gringolito/nearfield-speakers-support/nearfield-wall-mount.scad

// nearfield-wall-mount.scad
// Top-level: parameters (Customizer-friendly) + render_piece dispatch.

include <modules/common.scad>;
include <modules/joinery.scad>;
include <modules/base.scad>;
include <modules/platform.scad>;
include <modules/arm.scad>;

/* [Render] */
// 0 = assembly preview
// 1 = base-right          2 = base-left
// 3 = arm-right           4 = arm-left
// 5 = platform-right      6 = platform-left
render_piece = 0; // [0:assembly, 1:base-right, 2:base-left, 3:arm-right, 4:arm-left, 5:platform-right, 6:platform-left]

/* [Acoustic angles] */
toe_in_deg = 26; // [20:1:30]
tilt_deg   = 12; // [10:1:15]

/* [Arm geometry] */
arm_length  = 45;  // [40:5:100]
arm_root_h  = 60;  // [50:5:70]
arm_tip_h   = 28;  // [25:1:40]
arm_w       = 40;  // [35:5:50]

/* [Base geometry] */
base_h = 140; // [140:10:220]
base_w = 90;  // [80:10:140]
base_t = 6;   // [6:2:28]

/* [Base boss] */
// Frontal boss at the arm joint. Sized to match the arm's root cross-section
// so the boss visually reads as a continuation of the arm into the base. Its
// depth (in +Z) carries the lateral clamping screws into heat-set inserts in
// the arm root tenon. The boss front face is intentionally clipped flat (no
// fillet bulge) so it mates flush against the arm root.
boss_w       = arm_w;      // [30:2:50]   match arm_w
boss_h       = arm_root_h; // [40:5:70]   match arm_root_h
boss_depth   = 15;         // [15:1:25]
// Explicit chamfered skirt blending the boss into the slab. Height of the
// chamfer along +Z; lateral expansion at the slab is equal to this. 0 =
// no skirt (rely only on the minkowski fillet at the boss/slab corner).
boss_blend_h = 4;  // [0:1:8]

/* [Platform geometry] */
plat_depth        = 200;   // [200:10:300]
plat_w            = 130;   // [130:2:140]
plat_t            = 8;     // [8:1:14]
plat_boss_w       = arm_w; // [30:2:50]   match arm_w
plat_boss_depth   = 28;    // [25:1:40]
// Total back-face height of the boss = plat_t + plat_boss_extra_t.
// Sized to match arm_tip_h so the boss covers the entire arm tip face,
// making the joint read as a single piece (mirrors how boss_h matches
// arm_root_h at the base end of the arm).
plat_boss_extra_t = arm_tip_h - plat_t;  // [10:1:32]   match arm_tip_h - plat_t
// The mortise is centered at (plat_t + plat_boss_extra_t)/2 below the
// slab top — i.e., at the geometric center of the back face — so the
// arm tip face (also centered on its tenon) lands centered on the back
// face. No standalone mortise-drop parameter is needed: the back-face
// center IS the mortise. Keep plat_t + plat_boss_extra_t ≈ arm_tip_h to
// make the boss/slab back face cover the arm tip face exactly.
lip_h             = 15;  // [12:1:18]
lip_t             = 5;   // [5:1:8]

/* [Joints] */
tenon_h_plat = 12;
tenon_w_plat = 25;
tenon_l_plat = 20;
tenon_h_base = 25;
tenon_w_base = 22;
// Root tenon is fully passthrough — spans the slab plus the frontal boss.
tenon_l_base = base_t + boss_depth;
tenon_clearance = 0.1;  // per-side
insert_spacing  = 10;

/* [Wall mounting] */
wall_screw_count   = 2;
wall_screw_spacing = 100;

/* [Fillets & Chamfers] */
edge_r   = 2.0; // [0:0.5:6]
fillet_r = 1.0; // [0:0.5:6]
chamfer  = 1.0; // [0:0.5:6]

/* [Quality] */
$fn = 64;

// Sanity asserts on parameters that interact:
assert(tenon_l_plat + 5 <= plat_boss_depth,
       "platform mortise depth + 5 mm back wall must fit within platform thickness at boss");
assert(arm_tip_h <= arm_root_h,
       "arm must taper inward (tip height <= root height)");
// The two lateral clamping screws are stacked vertically (along Y) at the
// boss's mid-depth, so the vertical (Y) extent of the boss carries the
// spacing+wall-thickness constraint, while the depth (Z) only needs to be
// thick enough to clear the screw diameter on either side. Each free face
// of the boss should retain at least MIN_BOSS_SCREW_WALL mm of plastic
// around the screw to keep more than one perimeter at 0.4 mm nozzle.
assert(boss_h >= insert_spacing + SCREW_M4_D + 2*MIN_BOSS_SCREW_WALL,
       "boss_h too small to safely host two vertically-stacked lateral screws");
// The lateral screw sits at the midpoint of the boss main body (above
// the skirt), so the binding constraint is the main-body height, not the
// total boss depth. Main-body height = boss_depth - boss_blend_h.
assert(boss_depth - boss_blend_h >= SCREW_M4_D + 2*MIN_BOSS_SCREW_WALL,
       "boss main body too short to host the lateral screw between skirt top and front face");
assert(boss_w >= tenon_w_base + 2*MIN_BOSS_SCREW_WALL,
       "boss_w must be wider than the mortise plus screw-wall margins");
assert(boss_w <= base_w,
       "boss must fit within the base footprint laterally");
assert(boss_h <= base_h - 2*WALL_SCREW_HEAD_D,
       "boss must not overlap the wall screw counterbores");

// Platform boss must be wide enough to host the counterbore mouth
// (Ø SCREW_M4_HEAD_D) plus the far-side wall on the opposite face.
// The base's equivalent constraint is implied by the existing
// "boss_w >= tenon_w_base + 2*MIN_BOSS_SCREW_WALL" assert above
// (the mortise is wider than the counterbore mouth at M4).
assert(plat_boss_w >= SCREW_M4_HEAD_D + MIN_BOSS_SCREW_WALL,
       "plat_boss_w too small for counterbore mouth + far-side wall");

// --- Stub modules (filled in by subsequent tasks) ---
module base_module() {
    base_plate(base_h = base_h,
               base_w = base_w,
               base_t = base_t,
               tenon_h_base = tenon_h_base,
               tenon_w_base = tenon_w_base,
               tenon_l_base = tenon_l_base,
               tenon_clearance = tenon_clearance,
               wall_screw_count = wall_screw_count,
               wall_screw_spacing = wall_screw_spacing,
               insert_spacing = insert_spacing,
               boss_w = boss_w,
               boss_h = boss_h,
               boss_depth = boss_depth,
               boss_blend_h = boss_blend_h,
               chamfer = chamfer,
               edge_r = edge_r);
}
module arm_module() {
    arm(arm_length = arm_length,
        toe_in_deg = toe_in_deg,
        tilt_deg = tilt_deg,
        arm_root_h = arm_root_h,
        arm_tip_h = arm_tip_h,
        arm_w = arm_w,
        tenon_h_base = tenon_h_base,
        tenon_w_base = tenon_w_base,
        tenon_l_base = tenon_l_base,
        tenon_h_plat = tenon_h_plat,
        tenon_w_plat = tenon_w_plat,
        tenon_l_plat = tenon_l_plat,
        insert_spacing = insert_spacing,
        boss_depth = boss_depth,
        boss_blend_h = boss_blend_h,
        fillet_r = fillet_r,
        edge_r = edge_r);
}
module platform_module() {
    platform_body(plat_depth = plat_depth,
                  plat_w = plat_w,
                  plat_t = plat_t,
                  plat_boss_w = plat_boss_w,
                  plat_boss_depth = plat_boss_depth,
                  plat_boss_extra_t = plat_boss_extra_t,
                  lip_h = lip_h,
                  lip_t = lip_t,
                  tenon_h_plat = tenon_h_plat,
                  tenon_w_plat = tenon_w_plat,
                  tenon_l_plat = tenon_l_plat,
                  tenon_clearance = tenon_clearance,
                  insert_spacing = insert_spacing,
                  chamfer = chamfer,
                  edge_r = edge_r);
}
module assembly_preview() {
    // Show the right-hand bracket assembled.
    // Base in its real-world orientation: wall-facing face at y = 0, front at y = base_t.
    // Arm root tenon plugs into base's mortise.
    // Platform attaches at the arm tip.

    // Base — rotated so its front face is along +Y (matching arm root direction)
    color("steelblue")
        rotate([270, 0, 0])
            translate([-base_w/2, -base_h/2, 0])
                base_module();

    // Arm — root face mates against the front face of the base boss.
    arm_y_offset = base_t + boss_depth;
    color("seagreen", 0.99)
        translate([0, arm_y_offset, 0])
            arm_module();

    // Platform — translated to the arm tip. tip_pos is in arm-local frame;
    // arm sits at [0, arm_y_offset, 0] in world, so add arm_y_offset to Y.
    // Inner translate lifts the platform so the mortise centre lands at
    // arm-tip-local Z = 0, aligning it with the tip tenon.
    tip_pos   = arm_centerline_pos(1, arm_length, toe_in_deg, tilt_deg);
    tip_yaw   = arm_yaw(1, toe_in_deg);
    tip_pitch = arm_pitch(1, tilt_deg);
    color("darkorange", 0.99)
        translate([tip_pos[0], tip_pos[1] + arm_y_offset, tip_pos[2]])
            rotate([0, 0, tip_yaw])
            rotate([tip_pitch, 0, 0])
                translate([0, 0, (plat_t + plat_boss_extra_t) / 2])
                    platform_module();
}

// --- Dispatch ---
if      (render_piece == 0) assembly_preview();
else if (render_piece == 1) base_module();
else if (render_piece == 2) mirror([1,0,0]) base_module();
else if (render_piece == 3) arm_module();
else if (render_piece == 4) mirror([1,0,0]) arm_module();
else if (render_piece == 5) platform_module();
else if (render_piece == 6) mirror([1,0,0]) platform_module();
else assert(false, str("unknown render_piece: ", render_piece));
