gringolito/nearfield-speakers-support/(commit log)

2026-05-12 Add design spec for nearfield bookshelf wall mount
    Spec covers 3-piece modular bracket (base + arm + platform), distributed
    angle encoding (toe-in in base mortise, tilt in platform mortise), tenon-guided
    joints with M5 heat-set inserts, PLA+ material and 225x225mm print constraints.
2026-05-12 feat: project scaffold and parameter definitions
    Add main entry-point nearfield-wall-mount.scad with all Customizer
    parameters (acoustic angles, three pieces, joint, hardware, fillets,
    render dispatch) and module stubs that render a 1x1x1 placeholder cube.
    [assembly.scad, common.scad, nearfield-wall-mount.scad, piece1.scad, piece2.scad, piece3.scad]
2026-05-12 feat: add common utility modules (rounded_box, fillet_rod, mortise_box)
    Implements all four shared geometry utilities in modules/common.scad:
    rounded_box (minkowski sphere), fillet_rod (quarter-cylinder), countersunk_hole,
    and mortise_box (angled mortise cavity). Verified render exits 0 with no geometry errors.
    [common.scad]
2026-05-12 feat: implement Piece 2 arm with triangular ribs and tenon insert holes
    [piece2.scad]
2026-05-12 fix: correct rib extrusion axis, fillet quadrant, and insert hole epsilon in Piece 2
    [piece2.scad]
2026-05-12 feat: implement Piece 1 wall base plate with angled arm receiver boss
    [piece1.scad]
2026-05-12 fix: use axial Z-direction screw hole in Piece 1 boss (was incorrect lateral Y hole)
    [piece1.scad]
2026-05-12 feat: implement Piece 3 platform with tilt mortise and front safety lip
    [piece3.scad]
2026-05-12 feat: add assembly preview module (render_piece=0)
    Places all three pieces in installed orientation with per-piece colors
    for visual sanity-check. Renders clean with no errors or warnings.
    [assembly.scad]
2026-05-12 feat: add tenon/mortise fit test render
    [fit_test.scad]
2026-05-12 feat: add STL export script for all 4 pieces
2026-05-12 fix: add tenon stubs to Piece 2 arm (arm body is 35x30mm, tenons are 28x18mm)
    [piece2.scad]
2026-05-13 chore: add GitHub Actions CI/CD pipeline (#1)
    * docs: add CI/CD workflow design spec and implementation plan
    * feat: add STL validation script
    * feat: add CI workflow (build, render, validate)
    * feat: add release workflow (tag-triggered STL release)
    * fix: use xvfb-run -a to auto-select display number for OpenSCAD renders
2026-05-13 docs: add README, LICENSE, and CI render publishing (#2)
    * docs: add README, CC BY-SA 4.0 license, and ci-renders/latest support
    - README tells the project story (why fixed angles beat articulating
    mounts), covers quick start, assembly, full customization guide,
    print settings, BOM, vibration isolation, and adaptation ideas
    - LICENSE adds Creative Commons Attribution-ShareAlike 4.0 International
    - CI extended to push renders to ci-renders/latest/ on master pushes
    so README header and piece images auto-update on every merge
    * docs(readme): expand print settings with material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
2026-05-13 fix(ci): center renders on model bounding box (#3)
    All pieces are modeled in positive-coordinate space and not centered at
    origin. The fixed camera translate (0,0,0) caused every render to look
    past the model's corner, pushing geometry into the upper-right corner
    and clipping pieces.
    --autocenter overrides the translate component of --camera to the
    model's bounding box center; --viewall adjusts distance to fit the full
    model in frame. Both preserve the existing rotation angles (55,0,25).
2026-05-14 Re-architect bracket: 3D-curved arm encodes both toe-in and tilt (#4)
    * refactor: start it over again
    * docs: add design spec for re-architected nearfield wall mount
    Captures the brainstorming output for a 3-piece bracket where all angular
    complexity (toe-in and tilt) lives in a 3D-curved arm body, while the base
    and platform have only perpendicular joint interfaces. Includes geometry,
    joint mechanics with 6kg load analysis, parameter set, hardware BOM, and
    print orientation per piece.
    * feat: project skeleton with parameters and render_piece dispatch
    * feat: joinery prim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
    [arm.scad, arm_spike.scad, assembly.scad, base.scad, common.scad, fit_test.scad, joinery.scad, nearfield-wall-mount.scad]
2026-05-14 fix(assembly): align platform with arm tip in assembly preview (#5)
    Three bugs in assembly_preview caused the platform to float
    detached from the arm:
    1. Missing base_t offset — tip_pos is in arm-local frame but the arm
    is placed at translate([0, base_t, 0]), so the platform Y was
    short by 22 mm.
    2. Wrong inner Y translate — translate([0, tenon_l_plat, 0]) placed
    the platform back face at the far end of the tenon instead of at
    the arm shoulder, leaving no overlap between tenon and mortise.
    3. Missing Z lift — the platform origin is its top face (Z = 0), but
    the mortise centre sits at -(plat_t + plat_boss_extra_t/2) below
    that. Lifting by plat_t + plat_boss_extra_t/2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
    [nearfield-wall-mount.scad]
2026-05-14 feat: parametric edge rounding on all printed pieces (default 1 mm) (#6)
    * feat(common): add rounded_cube utility module
    * feat(base): round outer slab edges via rounded_cube, rename fillet_r→chamfer
    * feat(platform): round outer slab/boss/lip edges, rename fillet_r→chamfer
    * feat(arm): round cross-section edges via _arm_wafer, propagate edge_r
    * feat: wire edge_r/fillet_r/chamfer params — default 1 mm edge rounding
    * fix(platform): apply edge rounding to union, not individual solids
    Add fillet_solid(r) to common.scad — a minkowski+sphere wrapper that
    rounds only exposed external edges of a union. Rewrite platform_body(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
    [arm.scad, base.scad, common.scad, nearfield-wall-mount.scad, platform.scad]
2026-05-14 Passthrough arm-to-base tenon + platform geometry fix (#7)
    * fix(platform): preserve parametric dimensions and mate flush with arm
    The platform used fillet_solid() — a minkowski(sphere(r)) wrapper — which
    inflated the outer bounding box by r on every face, so the parametric
    width/depth/height were each r mm short of what the user specified. It
    also pushed the back face outward by r, leaving a visible gap between
    the boss and the arm tip in the assembly preview.
    Two-part fix in the union geometry passed to fillet_solid():
    1. Each piece (slab, boss, lip) is pre-inset by r on its external faces
    so post-minkowski dimensions match the requested parameters.
    2. The slab and boss extend i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
    [arm.scad, base.scad, nearfield-wall-mount.scad, platform.scad]
2026-05-14 feat(base): boss with lateral M5 retention for the arm joint (#8)
    * docs: add spec for arm-to-base boss retention
    Design document for re-introducing positive retention at the
    arm/base joint after #7 removed the lateral clamping screws. Covers
    the boss geometry, vertical screw layout for moment-couple
    resistance, minkowski-based fillet pattern matching platform.scad,
    and the insert/screw alignment math.
    * feat(base): boss with lateral M5 retention for the arm joint
    Re-introduces positive retention at the arm-to-base joint after #7
    removed the lateral clamping screws. Adds a frontal boss to the base
    that carries two M5 cap screws in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
    [arm.scad, base.scad, common.scad, nearfield-wall-mount.scad]
2026-05-14 feat(platform): boss back face matches arm tip cross-section (#9)
    The platform-to-arm joint now reads as a single continuous piece, the
    same way the base boss already does at the arm root. Previously the
    boss back face was 8 mm shorter than the arm tip face, leaving the tip
    visibly protruding below the platform.
    The mortise center is now anchored at the geometric center of the full
    back face (slab + boss), so the arm tip face — itself centered on its
    tenon — lands centered on the platform back face. Plat_boss_extra_t is
    derived as `arm_tip_h - plat_t`, and plat_boss_w / boss_w / boss_h are
    bound to their arm counterparts so the four "matching" dimensions stay
    in sync automatically inste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
    [nearfield-wall-mount.scad, platform.scad]
2026-05-14 chore(ci): rotate renders camera so X/Y axes match standard orientation (#10)
    Changes the CI PNG render camera rotation from rz=25 to rz=115. With
    rx=55, the previous angle placed +X at lower-right and +Y at upper-right.
    The new angle places +X at lower-left and +Y at lower-right (Z up), which
    matches the conventional 3D viewer orientation and gives a clearer view
    of the back plate, arm joint, and platform lip.
2026-05-15 feat: handed base and platform with cosmetic counterbore (#11)
    * docs(spec): handed base and platform with cosmetic counterbore
    Specifies making base_plate() and platform_body() canonically right-hand
    with mirror([1,0,0]) for left, matching the existing arm convention.
    Clamping-screw holes become blind on one face (3 mm far wall) and gain
    a shallow cosmetic counterbore for the SHCS head on the entry face.
    * refactor(common): move MIN_BOSS_SCREW_WALL to common.scad and add SCREW_M5_COUNTERBORE_DEPTH
    * refactor(joinery): extend clamping_screw_hole with counterbore and far_wall params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
    [base.scad, common.scad, joinery.scad, nearfield-wall-mount.scad, platform.scad]
2026-05-15 refactor(hardware): replace M5 screws with M4 throughout (#12)
    Switch all joint clamping hardware from M5 to M4 (clearance hole 4.3 mm,
    SHCS head ∅7.5 × 4.0 mm, heat-set insert ∅5.7 × 6.0 mm). M5 constants
    are kept in common.scad as reference for future use.
    [arm.scad, base.scad, common.scad, joinery.scad, nearfield-wall-mount.scad, platform.scad]
