gringolito/nearfield-speakers-support/(notices)

Notices in the files:
README.md:
License: CC BY-SA 4.0
